Rb3111-ship/HOPE/docs/assets/PCB_PCB3_2026-05-07.pdf

hope.

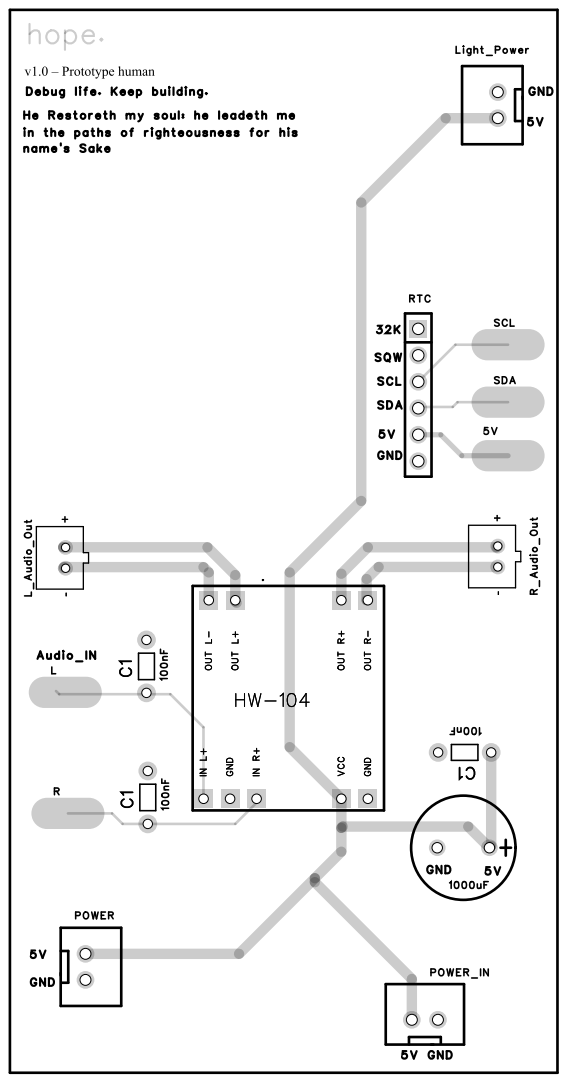
[picture p3: page 1]

v1.0 – Prototype human
Debug life. Keep building.
He Restoreth my soul: he leadeth me
in the paths of righteousness for his
name's Sake

IN L+ GND IN R+ VCC GND

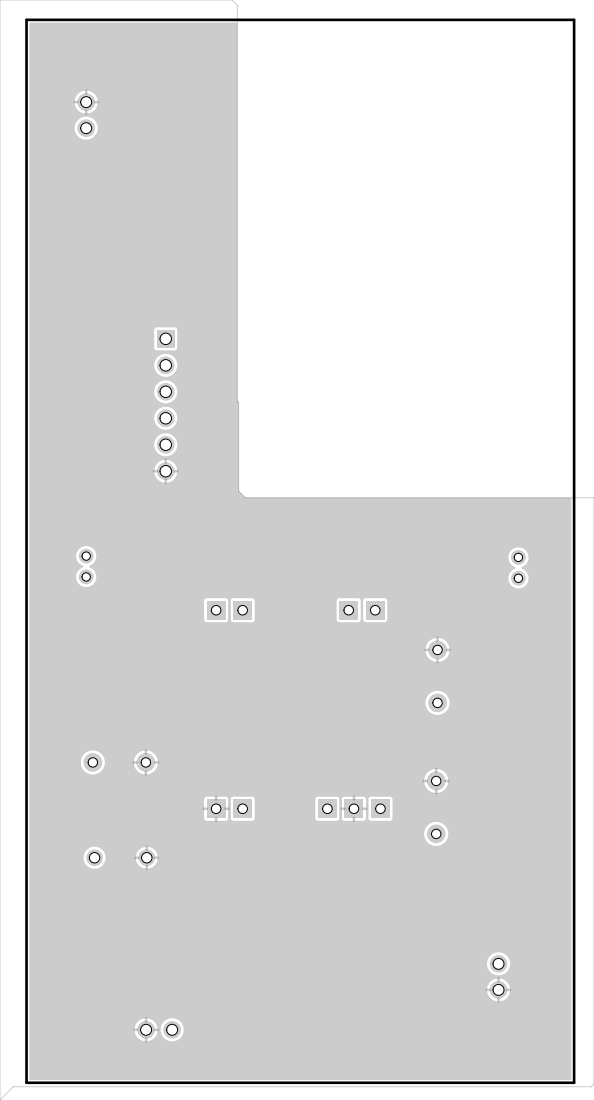
[picture p4: page 2]

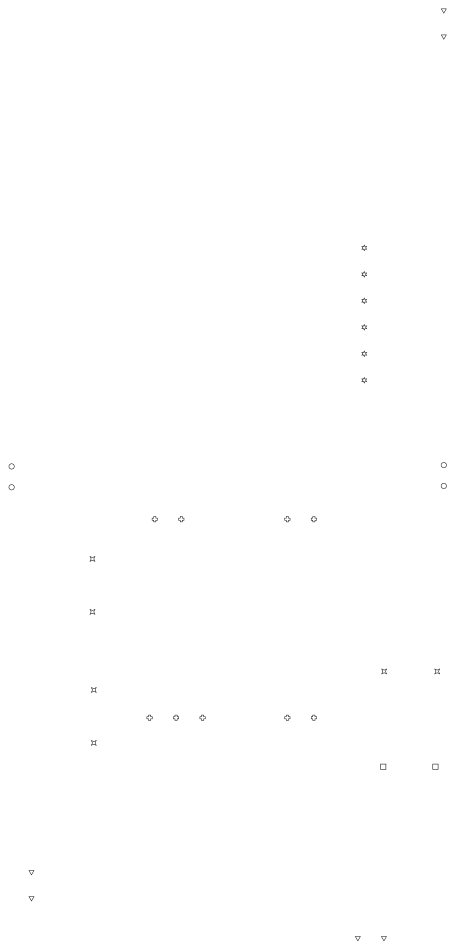
[picture p5: page 3]
