Rb3111-ship/HOPE/docs/assets/PCB_PCB2_2026-05-07.pdf

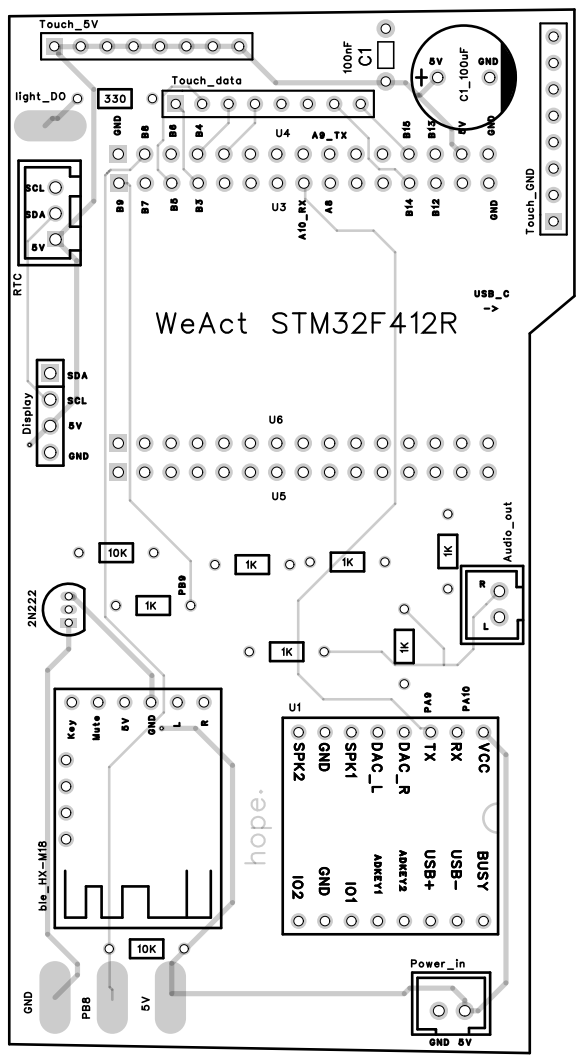
[picture p6: page 1]

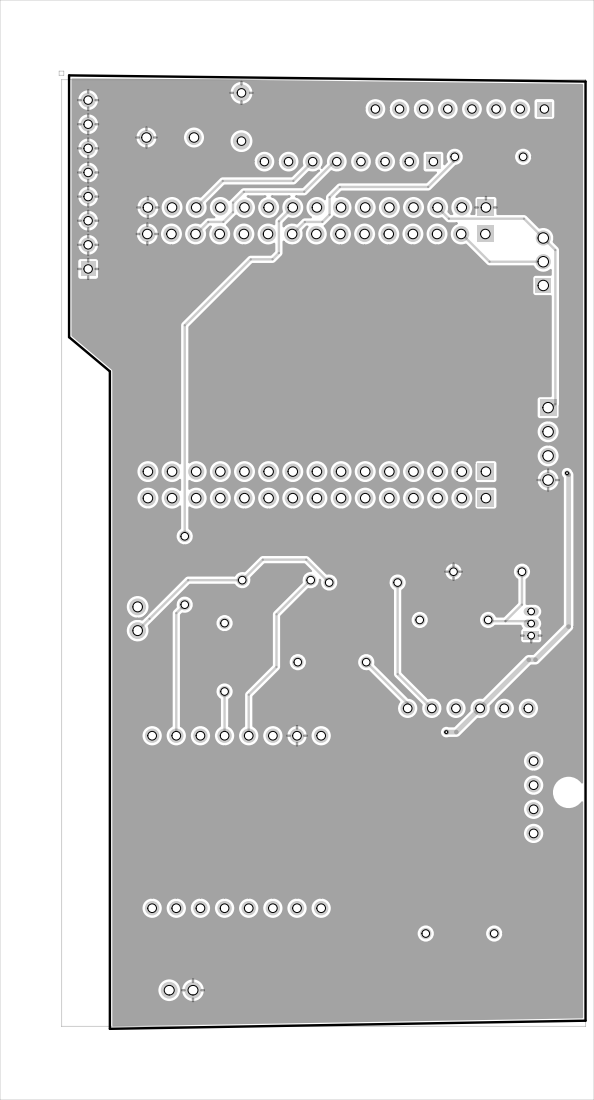
[picture p7: page 2]

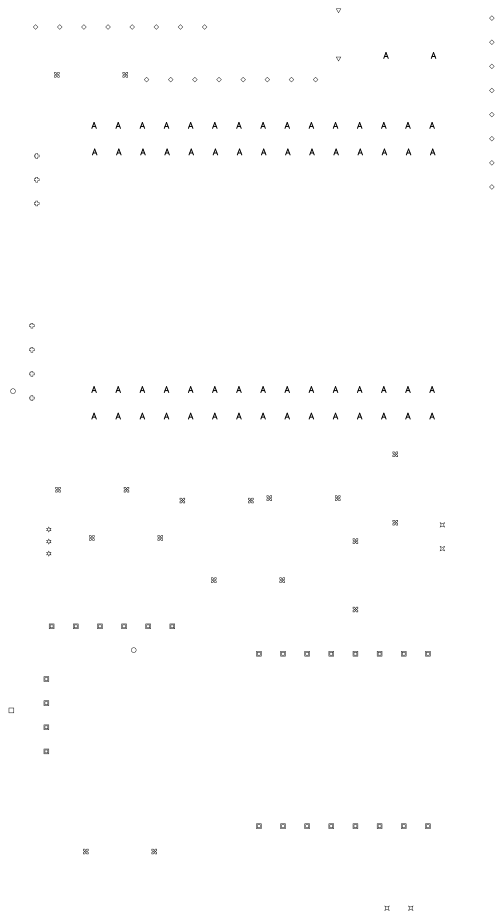
[picture p8: page 3]
