Rb3111-ship/HOPE/Core/Src/main.c

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
/* Includes ------------------------------------------------------------------*/
#include "main.h"
#include "cmsis_os.h"

/* USER CODE BEGIN Includes */

#include "tasks.h"
#include "FreeRTOS.h"
#include "task.h"
#include "queue.h"
#include "app_queue.h"
#include "ui_state.h"
#include "music.h"
#include "semphr.h"
#include "DHT22_driver.h"
#include "alarm_service.h"
#include "light.h"

/* USER CODE END Includes */

I2C_HandleTypeDef hi2c1;
DMA_HandleTypeDef hdma_i2c1_tx;

TIM_HandleTypeDef htim1;
DMA_HandleTypeDef hdma_tim1_ch1;

UART_HandleTypeDef huart1;
DMA_HandleTypeDef hdma_usart1_tx;
DMA_HandleTypeDef hdma_usart1_rx;

/* Definitions for defaultTask */
osThreadId_t defaultTaskHandle;
const osThreadAttr_t defaultTask_attributes = {
  .name = "defaultTask",
  .stack_size = 128 * 4,
  .priority = (osPriority_t) osPriorityNormal,
};
/* USER CODE BEGIN PV */

QueueHandle_t uiQueueHandle;
QueueHandle_t musicQueueHandle;
QueueHandle_t lightQueueHandle;
SemaphoreHandle_t i2c_dma_sem;
SemaphoreHandle_t i2c_mutex;

/* USER CODE END PV */

void SystemClock_Config(void);
static void MX_GPIO_Init(void);
static void MX_DMA_Init(void);
static void MX_I2C1_Init(void);
static void MX_USART1_UART_Init(void);
static void MX_TIM1_Init(void);
void StartDefaultTask(void *argument);

/* USER CODE BEGIN 0 */

BaseType_t createTasks() {

	BaseType_t status1 = xTaskCreate(ui_Task, "UI Task", 1000,
	NULL, 2,
	NULL);

	// Music runs one level above the UI so audio commands aren't delayed by
	// screen redraws or the ~6 ms DHT22 read in the UI task
	BaseType_t status2 = xTaskCreate(music_Task, "music Task", 1000,
	NULL, 3,
	NULL);

	BaseType_t status3 = xTaskCreate(light_Task, "light Task", 1000,
	NULL, 1,
	NULL);

	if (status1 != pdPASS || status2 != pdPASS || status3 != pdPASS) {
		return pdFAIL;
	}
	return pdPASS;

}

/* USER CODE END 0 */

/**
  * @brief  The application entry point.
  * @retval int
  */
int main(void)
{

  /* MCU Configuration--------------------------------------------------------*/

  /* Reset of all peripherals, Initializes the Flash interface and the Systick. */
  HAL_Init();

  /* Configure the system clock */
  SystemClock_Config();

  /* Initialize all configured peripherals */
  MX_GPIO_Init();
  MX_DMA_Init();
  MX_I2C1_Init();
  MX_USART1_UART_Init();
  MX_TIM1_Init();
  /* USER CODE BEGIN 2 */
	DHT22_init();
	alarm_service_init();
  /* USER CODE END 2 */

  /* Init scheduler */
  osKernelInitialize();

  /* USER CODE BEGIN RTOS_MUTEX */
	/* add mutexes, ... */
  /* USER CODE END RTOS_MUTEX */

  /* USER CODE BEGIN RTOS_SEMAPHORES */
	/* add semaphores, ... */

	i2c_dma_sem = xSemaphoreCreateBinary();
	i2c_mutex =  xSemaphoreCreateMutex();

	if (i2c_dma_sem == NULL || i2c_mutex == NULL) {
		NVIC_SystemReset();
	}
  /* USER CODE END RTOS_SEMAPHORES */

  /* USER CODE BEGIN RTOS_TIMERS */
	/* start timers, add new ones, ... */
  /* USER CODE END RTOS_TIMERS */

  /* USER CODE BEGIN RTOS_QUEUES */
	/* add queues, ... */

	uiQueueHandle = xQueueCreate(8, sizeof(ui_msg_t));

	if (uiQueueHandle == NULL) {
		NVIC_SystemReset();
	}

	musicQueueHandle = xQueueCreate(8, sizeof(music_msg_t));

	if (musicQueueHandle == NULL) {
		NVIC_SystemReset();
	}

	lightQueueHandle = xQueueCreate(8, sizeof(light_msg_t));
	if (lightQueueHandle == NULL) {
		NVIC_SystemReset();
	}

  /* USER CODE END RTOS_QUEUES */

  /* Create the thread(s) */
  /* creation of defaultTask */
  defaultTaskHandle = osThreadNew(StartDefaultTask, NULL, &defaultTask_attributes);

  /* USER CODE BEGIN RTOS_THREADS */
	/* add threads, ... */

	if (createTasks() != pdPASS) {
		NVIC_SystemReset();
	}

	//Put in own function so you can do error checking
  /* USER CODE END RTOS_THREADS */

  /* USER CODE BEGIN RTOS_EVENTS */
	/* add events, ... */
  /* USER CODE END RTOS_EVENTS */

  /* Start scheduler */
  osKernelStart();

  /* We should never get here as control is now taken by the scheduler */

  /* Infinite loop */
  /* USER CODE BEGIN WHILE */
	while (1) {

    /* USER CODE END WHILE */

    /* USER CODE BEGIN 3 */
	}
  /* USER CODE END 3 */
}

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
/* USER CODE BEGIN 4 */

static void i2c_bus_delay(void) {
	for (volatile uint32_t i = 0; i < 500; i++) {
		__NOP(); // a few microseconds at 100 MHz (~100 kHz bit-bang)
	}
}

/**
 * @brief Recovers I2C1 (OLED + DS3231) after a timeout, stuck BUSY flag or bus error.
 * @details De-initialises the peripheral, clocks out up to 9 SCL pulses so a slave
 *          that is holding SDA low can finish its byte, sends a STOP, then
 *          re-initialises I2C1 (MspInit restores the pins, DMA link and IRQs).
 *          Caller must own i2c_mutex (or be the only bus user).
 */
void i2c1_bus_recover(void) {
	GPIO_InitTypeDef GPIO_InitStruct = { 0 };

	HAL_I2C_DeInit(&hi2c1);

	__HAL_RCC_GPIOB_CLK_ENABLE();
	HAL_GPIO_WritePin(GPIOB, GPIO_PIN_6 | GPIO_PIN_7, GPIO_PIN_SET);
	GPIO_InitStruct.Pin = GPIO_PIN_6 | GPIO_PIN_7; // PB6 = SCL, PB7 = SDA
	GPIO_InitStruct.Mode = GPIO_MODE_OUTPUT_OD;
	GPIO_InitStruct.Pull = GPIO_NOPULL;
	GPIO_InitStruct.Speed = GPIO_SPEED_FREQ_HIGH;
	HAL_GPIO_Init(GPIOB, &GPIO_InitStruct);
	i2c_bus_delay();

	for (int i = 0; i < 9; i++) {
		if (HAL_GPIO_ReadPin(GPIOB, GPIO_PIN_7) == GPIO_PIN_SET) {
			break; // SDA released
		}
		HAL_GPIO_WritePin(GPIOB, GPIO_PIN_6, GPIO_PIN_RESET);
		i2c_bus_delay();
		HAL_GPIO_WritePin(GPIOB, GPIO_PIN_6, GPIO_PIN_SET);
		i2c_bus_delay();
	}

	// STOP condition: SDA low -> high while SCL is high
	HAL_GPIO_WritePin(GPIOB, GPIO_PIN_7, GPIO_PIN_RESET);
	i2c_bus_delay();
	HAL_GPIO_WritePin(GPIOB, GPIO_PIN_6, GPIO_PIN_SET);
	i2c_bus_delay();
	HAL_GPIO_WritePin(GPIOB, GPIO_PIN_7, GPIO_PIN_SET);
	i2c_bus_delay();

	HAL_GPIO_DeInit(GPIOB, GPIO_PIN_6 | GPIO_PIN_7);
	HAL_I2C_Init(&hi2c1);
}

/* USER CODE END 4 */

/* USER CODE BEGIN Header_StartDefaultTask */
/**
 * @brief  Function implementing the defaultTask thread.
 * @param  argument: Not used
 * @retval None
 */
/* USER CODE END Header_StartDefaultTask */
void StartDefaultTask(void *argument)
{
  /* USER CODE BEGIN 5 */
	/* CubeMX's default task has no job in this design (the work is in the UI,
	 * music and light tasks). It ran at osPriorityNormal (24), above all of them,
	 * waking every 1 ms; delete it so the idle task frees its stack/TCB. */
	vTaskDelete(NULL);
  /* USER CODE END 5 */
}

/**
  * @brief  Period elapsed callback in non blocking mode
  * @note   This function is called  when TIM11 interrupt took place, inside
  * HAL_TIM_IRQHandler(). It makes a direct call to HAL_IncTick() to increment
  * a global variable "uwTick" used as application time base.
  * @param  htim : TIM handle
  * @retval None
  */
void HAL_TIM_PeriodElapsedCallback(TIM_HandleTypeDef *htim)
{
  if (htim->Instance == TIM11)
  {
    HAL_IncTick();
  }
}

/**
  * @brief  This function is executed in case of error occurrence.
  * @retval None
  */
void Error_Handler(void)
{
  /* USER CODE BEGIN Error_Handler_Debug */
	/* User can add his own implementation to report the HAL error return state */
	__disable_irq();
	while (1) {
	}
  /* USER CODE END Error_Handler_Debug */
}
#ifdef USE_FULL_ASSERT
/**
  * @brief  Reports the name of the source file and the source line number
  *         where the assert_param error has occurred.
  * @param  file: pointer to the source file name
  * @param  line: assert_param error line source number
  * @retval None
  */
void assert_failed(uint8_t *file, uint32_t line)
{
  /* USER CODE BEGIN 6 */
  /* User can add his own implementation to report the file name and line number,
     ex: printf("Wrong parameters value: file %s on line %d\r\n", file, line) */
  /* USER CODE END 6 */
}
#endif /* USE_FULL_ASSERT */
