Rb3111-ship/HOPE/Core/Inc/main.h

#define LED_TOGGLE_Pin GPIO_PIN_2
#define LED_TOGGLE_GPIO_Port GPIOB
#define BTN_MUSIC_Pin GPIO_PIN_12
#define BTN_MUSIC_GPIO_Port GPIOB
#define BTN_MUSIC_EXTI_IRQn EXTI15_10_IRQn
#define BTN_TIMER_Pin GPIO_PIN_13
#define BTN_TIMER_GPIO_Port GPIOB
#define BTN_TIMER_EXTI_IRQn EXTI15_10_IRQn
#define BTN_VOL_UP_Pin GPIO_PIN_14
#define BTN_VOL_UP_GPIO_Port GPIOB
#define BTN_VOL_UP_EXTI_IRQn EXTI15_10_IRQn
#define BTN_DWN_Pin GPIO_PIN_15
#define BTN_DWN_GPIO_Port GPIOB
#define BTN_DWN_EXTI_IRQn EXTI15_10_IRQn
#define BTN_LIGHT_Pin GPIO_PIN_2
#define BTN_LIGHT_GPIO_Port GPIOD
#define BTN_LIGHT_EXTI_IRQn EXTI2_IRQn
#define BTN_UP_Pin GPIO_PIN_3
#define BTN_UP_GPIO_Port GPIOB
#define BTN_UP_EXTI_IRQn EXTI3_IRQn
#define BTN_PLAY_Pin GPIO_PIN_4
#define BTN_PLAY_GPIO_Port GPIOB
#define BTN_PLAY_EXTI_IRQn EXTI4_IRQn
#define BTN_VOL_DWN_Pin GPIO_PIN_5
#define BTN_VOL_DWN_GPIO_Port GPIOB
#define BTN_VOL_DWN_EXTI_IRQn EXTI9_5_IRQn
#define DHT22_DATA_Pin GPIO_PIN_8
#define DHT22_DATA_GPIO_Port GPIOB
#define BLE_SWITCH_Pin GPIO_PIN_9
#define BLE_SWITCH_GPIO_Port GPIOB
