Rb3111-ship/HOPE/Core/Src/Drivers/ble_driver.h

/*
 * ble_driver.h
 *
 * Created on: 4 May 2026
 * Author: whp27
 */

#ifndef SRC_DRIVERS_BLE_DRIVER_H_
#define SRC_DRIVERS_BLE_DRIVER_H_

// Low-level GPIO power toggle prototypes
void BLE_Power_On(void);
void BLE_Power_Off(void);

#endif /* SRC_DRIVERS_BLE_DRIVER_H_ */
