Rb3111-ship/HOPE/(commit log)

2026-04-24 Added driver for sh1107 oled monochrome display. modified it with semaphore .
2026-04-29 Added DS3231 RTC I2C driver with BCD To Decimal conversion . I connected this to the ui_Task allowing for time managment even without power
2026-05-05 Added music service functionality as well as polished RTC and dht22 sensor code.
2026-05-07 Add circuit diagrams and project files
2026-05-07 Add circuit diagrams
2026-05-13 Error fixes and added Alarm system to ui_task
    [ui_task.c]
2026-10-03 Fix OLED/I2C: SH1107 init, I2C1 IRQs, timeouts and bus recovery
    - Enable the I2C1 event/error interrupts. HAL finishes a DMA memory
    write in HAL_I2C_EV_IRQHandler, so without them the TX-complete
    callback never ran and the UI task blocked forever on the first
    screen refresh.
    - Add an SH1107 init path (SSD1306_USE_SH1107). The library's SSD1306
    sequence sends commands the SH1107 doesn't have (0x8D, 0xDA, 0x40)
    and never configures its DC-DC (0xAD). Offset, DC-DC, contrast and
    mirroring are tunable in ssd1306_conf.h.
    - Every OLED/RTC transfer now has a timeout, takes the shared
    i2c_mutex, and recovers the bus (i2c1_bus_recover) after a timeout
    or bus error; HAL_I2C_ErrorCallbac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
    [DS3231_RTC_driver.c, DS3231_RTC_driver.h]
2026-10-03 Fix DFPlayer audio: play by file name, looping, command pacing
    - Play tracks with command 0x12 (/MP3/NNNN.mp3) so the song that plays
    matches the name on screen; 0x03 used FAT copy order.
    - Loop the current track in software: the driver now receives the
    module's UART replies and reports the 0x3D "track finished" event,
    and music_Task restarts the track (lullaby for the whole sleep
    timer, alarm tone until dismissed). Works on clones that ignore the
    built-in loop command.
    - Leave 60 ms between commands so the module doesn't drop them; make
    the TX queue safe between the task and the TX-complete interrupt.
    - Bluetooth mode stops SD playback first.
    - Rename the driver API to df_* (pau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
    [DFPLAYER_driver.c, DFPLAYER_driver.h, music.h, music_task.c]
2026-10-03 Fix DHT22 reads after the first one; longer WS2812 reset
    DHT22:
    - Switch PB8 back to an (open-drain) output before every read. After
    the first read it stayed in timer-capture mode, so the start pulse
    never reached the sensor and every later read timed out (0 C / 0 %).
    - Release the line and arm the capture immediately (inside a critical
    section) instead of driving it high for 30 us, which raced the
    sensor's 20-40 us response and shifted every bit.
    - Keep the last good reading when a read fails; report whether any
    reading exists yet so the screen can show "--".
    WS2812:
    - 320 us reset gap (was 100 us; newer WS2812B need >= 280 us).
    - PWM DMA callbacks ignore timers other than TIM1;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
    [DHT22_driver.c, DHT22_driver.h, WS2812_driver.c, WS2812_driver.h, light_task.c]
2026-10-03 Save alarms in the RTC module's EEPROM; fix midnight alarms
    - New AT24C32 driver (address 0x57, the EEPROM on DS3231 modules),
    sharing the I2C mutex and bus recovery. Alarms are saved as one
    checksummed 32-byte page on every add/delete and restored at start-up,
    so they survive unplugging; a blank/corrupt EEPROM is ignored.
    - Reset "already rang today" flags when the clock wraps past midnight,
    so an alarm set for 00:00 works every day.
    - Don't judge alarms until the RTC has really been read, and re-sync
    after the user sets the clock, so passed alarms don't fire at boot.
    [AT24C32_driver.c, AT24C32_driver.h]
2026-10-03 Fix UI state machine: stuck menus, alarms, timer and player state
    - Start the OLED (ssd1306_Init was never called) and load saved alarms
    at the top of ui_Task.
    - Light menu: remember the previous screen only on the first press;
    repeated presses no longer trap the UI on a blank screen. MENU
    closes it; the previous screen and pop-up are restored.
    - Volume pop-up no longer becomes permanent after two quick presses.
    - Alarms: empty slot opens "Add", active slot opens "Delete?"; the
    delete prompt is modal and waits for YES/NO (MENU cancels). Alarm
    list context is registered. Pop-up timers can't clobber the alarm
    screen; the previous screen, pop-up and light mode come back after
    it;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
    [ui_task.c]
2026-10-03 RTOS and project config: hooks, priorities, relative include paths
    - main.c: i2c1_bus_recover(); check that the I2C semaphore and mutex
    were created; music task priority 3 (UI 2, light 1); the unused
    CubeMX defaultTask (priority 24, waking every 1 ms) deletes itself.
    - Enable stack-overflow checking (level 2) and the malloc-failed hook
    (debug build halts in the hook, release build resets).
    - Mirror the FreeRTOS settings (20 KB heap, FPU, hooks) and the I2C1
    interrupts into Hope_V1.ioc so CubeMX regeneration keeps them.
    - .cproject: Drivers/Services include paths were absolute
    (D:\ST projects\Hope_V1\...); make them project-relative.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
    [Hope_V1.ioc, main.c, main.h]
2026-10-03 Docs: code review reports, song list, SD card layout
    - CODE_REVIEW_SUMMARY.md: plain-English list of the issues found, by
    severity, plus a first-flash checklist.
    - CODE_REVIEW_FIXES.md: detailed fix reference with a progress log.
    - songs.md: current song titles and the SD file each one maps to
    (title of 0006.mp3 still to be filled in).
    - README: SD card layout (/MP3/NNNN.mp3, 0026 = alarm), DHT22 (not
    DHT11), alarms saved in EEPROM, updated directory tree, closed an
    unterminated code block.
2026-10-03 Volume buttons on every screen; filter touch noise
    - Volume +/- now work on all screens (except Bluetooth mode, where the
    phone sets the volume). They used to work only on the music screens,
    so after power-up on the home screen they seemed dead.
    - Touch noise filter: re-read the sensor pin 25 ms after the edge and
    drop it if it's already low (a noise spike, not a finger), and ignore
    a second edge from the same sensor within 150 ms. ui_msg_t gains a
    tick field; the EXTI callback records the pin and time.
    [ui_task.c]
2026-10-03 Replace bunny animation with a Chrome-style running T-rex
    The home and player screens now show a T-rex running along a scrolling
    desert floor, jumping over cacti (small, tall, double) with clouds
    drifting by. Sprites are text rows ('#' = pixel) so the art is easy
    to edit; the loop is seamless over the 240-frame animation counter.
    Jump timing (JUMP_H 20, JUMP_LEAD 18, JUMP_TAIL 4) was checked
    pixel-by-pixel in a simulation: at least 3 px clearance over every
    cactus. Removes the unused bunny, big star and music-note helpers.
2026-10-03 Docs: hardware guide for the PCB redesign; CLAUDE.md progress notes
    - HARDWARE_GUIDE.md: whole-system description for merging the two
    boards into one: fixed MCU pin map, power budget and decoupling,
    pin-by-pin connections, upgrades (solid ground plane, series amp
    coupling caps, high-side Bluetooth switch, correct display SDA/SCL,
    LED level shifter), layout zones, routing rules, connectors,
    pitfalls, pre-order checklist and a full netlist.
    - CLAUDE.md: project context, conventions, build-check recipe and
    current status/open items for future sessions.
